3128771573/stm32-test/level_dashboard_2026-10-09/docs/screen-simplified.png

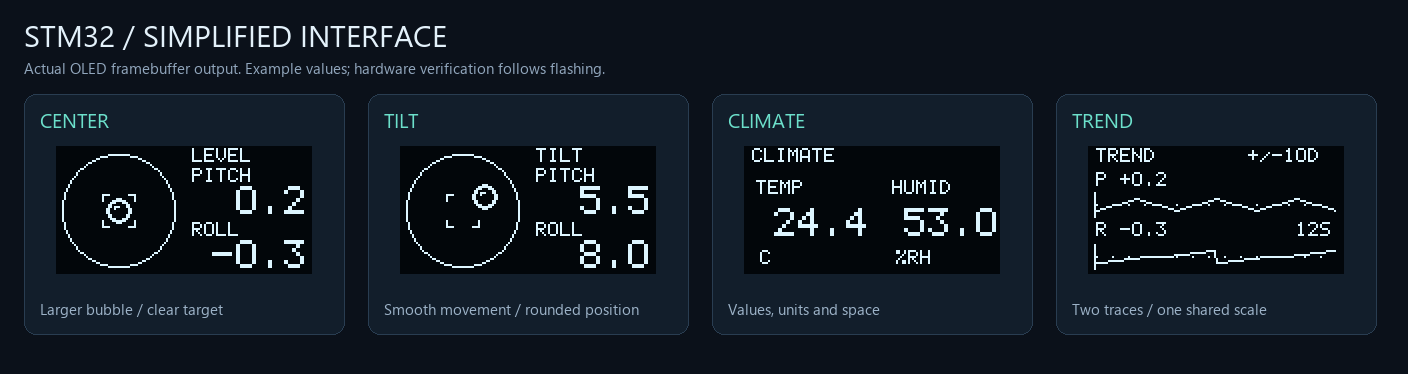
level_dashboard_2026-10-09/docs/screen-simplified.png
