3128771573/stm32-test/level_dashboard_2026-10-09/docs/screen.png

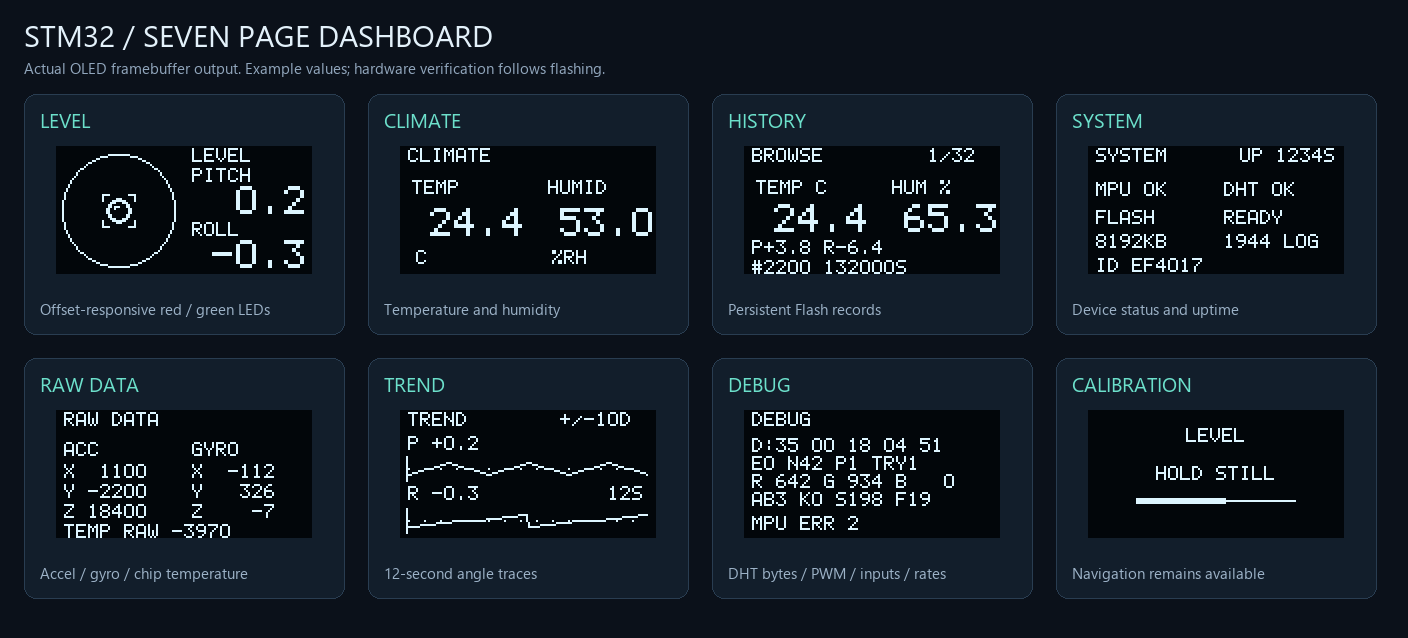
level_dashboard_2026-10-09/docs/screen.png
