3128771573/stm32-test/level_dashboard_2026-10-09/docs/validation.md

# 软件验证与实机验收

> 当前发布：2026-10-10 E（屏显版本 `20261010E`）。本页先列当前版本的构建与验收状态，后半部分保留此前迭代的测试记录供追溯。

## 当前发布：2026-10-10 E

| 检查项 | 结果 |
|---|---|
| Keil ARM Compiler 5.06 update 7 | 0 错误、0 警告 |
| ROM（map Total ROM） | 31,536 B |
| RAM（RW + ZI） | 8,048 B |
| 当前 HEX SHA-256 | `E5E01E7FB6E05E1369147C6647CB159F22D57C45F70B46F334656BDD6B7F6FB8` |
| 本次新增 | 开机序号、复位原因、当前运行时长、Flash 历史会话与 60 秒检查点 |
| 待板上验收 | 开机事件提交/读回、会话浏览、断电后的时长下界、并行运行稳定性 |

PC 逻辑验证通过不等于真实 Flash 掉电行为已验收。每分钟检查点只能给出意外断电前时长下界；没有后备电源时无法保存准确断电时刻。逐步验收方法见[页面与硬件验收](dashboard.md)。

`screen.png` 和 `screen-simplified.png` 是早期七页版本的绘图示例，保留作历史布局参考；其中不包含 STROBE、RUNTIME、SESSIONS，不能代表当前完整页面。当前接线和操作以新版 README 及本目录其他文档为准。

## 历史迭代验证记录

以下资源数、页面截图和验收结论对应各自标题中的旧版本，不能用于描述当前 E 版。原 ST 标准库未修改；USER 源码保持 GBK，build.cmd 保持 CRLF。

## 本次一次性断言检查

测试代码放在系统 TEMP，直接使用真实 main / oled / logger / dht11 / controls / dashboard 代码，替换外设访问。
GCC C99：Wall / Wextra / Werror，仅豁免原第三方字库的 missing-braces 提示。
未重新建立 level_sim，也没有在工程中留下 PC 仿真框架。

- DHT11 校验和正确 / 错误、小数温度、负温度编码验证通过。
- 通过真实 EXTI1_IRQHandler 注入响应和 40 位下降沿，验证收满一帧、TIM2 16 位回绕和超时错误。
- 编码器完整四边沿周期只产生一个事件，往返抖动取消；按键去抖、短按、长按及松手不重复短按通过。
- 后台校准 100 次正常完成；有效样本不足、明显运动、倒置均拒绝。
- Flash 记录正文写入后、提交前中断，再初始化扫描，未提交记录不计入有效数据。
- 下一次保存跳过未提交槽，不覆盖上一条已提交记录。
- 修改已提交记录的数据字节造成 CRC 错误，扫描忽略损坏记录。
- 未知非空数据触发 FOREIGN/LOCKED，拒绝写入并保留原字节。
- 模拟编程未生效，回读检测为 ERROR；模拟擦除长时间忙，截止时间后返回 ERROR。
- 连续写入 2200 条记录，跨过 2048 槽边界；当时有效数 1944，最新序号 2200。
- 重启扫描后仍为 1944 条，最近 32 条按 2200、2199……2169 正确排序。
- 各页及校准页从实际绘图函数导出，检查标题、数字、单位、记录时间和页码；screen.png 为合成样例值预览。

测试中的 Flash 后端执行 NOR 的 1→0 编程、4KB 扇区擦除和忙状态，以验证记录状态机。
它不替代真实 SPI 电气时序、擦写耗时、掉电电压曲线或 DHT11 实测脉冲；这些由板上验收确认。

## 保留的水平仪优化

前一版已检查连续滤波、数字滞回、水平进入/退出保持、时钟回绕和 OLED 差分重发。
当时 ±200 LSB 交替输入，稳定输出峰值 6 LSB；4800 LSB 阶跃第 40 个样本误差 61 LSB。
本版保留该滤波和判定逻辑，新增独立页面与后台校准。

原七阶段水平仪有完整硬件通过记录；本多功能版 DHT 恢复读取已由用户确认，其余新增行为仍需逐项验收。
完整接线和每项可观测验收见 [dashboard.md](dashboard.md)。

## 2026-10-09 按压 / DHT 诊断补充

增加按住 KEY DOWN、系统页 K:UP/K:DOWN、长按 HOME 提示和 DHT 的 E/N/P/TRY 诊断。
DHT 请求期间开漏输出，接收期间切换输入上拉。
本次 AC5 编译 0 错误、0 警告，Code=15952、RO=2032、RW=200、ZI=3392 字节。
临时测试验证输入/输出模式切换、无响应 E3、请求前低电平超时 E5、异常间隔 E4、恢复正常后 N42，以及按住/松手状态和短长按事件。
原温湿度解码、校准、Flash 掉电和循环记录测试继续通过；仍需用户烧录后反馈实际诊断码。

## DHT 一直 E3 N0 的根因与修复

用户实测：TRY 持续增加，PA1 接地后 P0/E5，三针模块直连后仍 E3 N0 P1。
检查实际 stm32f10x_exti.c 发现 EXTI_Init(LineCmd=DISABLE) 只关掩码，不配置触发寄存器。
原驱动在此分支初始化，随后只打开 IMR，导致 FTSR 的 EXTI1 位一直为 0，传感器下降沿无法触发接收。
修正为 LineCmd=ENABLE 先完成下降沿配置，再手动屏蔽 IMR，接收前启用。

旧临时测试把 EXTI_Init 替换为空函数并直接调用 ISR，验证了脉冲解码，但漏掉触发寄存器配置，不能作为此前 EXTI 链路正确的证据。
本次从项目原厂库提取实际 EXTI_Init 函数，仅把地址临时变量/转换改成 uintptr_t 以适配 64 位测试宿主。
对照相同函数的初始化结果：旧版 FTSR=0、IMR=0；修复版 FTSR=2、IMR=0。
回归脉冲必须经过 FTSR 与 IMR 门控才能进入真实 DHT ISR，完整帧、超时、错误脉冲与恢复测试通过。
AC5 编译 0 错误、0 警告，Code=15972、RO=2032、RW=200、ZI=3392 字节。
修复确切的初始化缺陷；实际模块通信恢复仍需用户烧录新 hex 验收。

## LED PWM 平滑优化

用户随后确认 DHT11 已恢复正常。
LED 从 SysTick 100Hz、9 档软件 PWM 改为 TIM1 三通道 2kHz、3600 级硬件 PWM。
临时测试运行真实 controls.c，检查 PSC/ARR、PWM1、预装载、通道输出和高级定时器 MOE 配置。
视觉补偿在全部 65281 个 Q8 输入上单调且有界，0 输入全灭、满输入占空比 3600。
蓝色 3 秒呼吸实算占空比 10–1789，包含 260 种亮度值，最大单步变化 16/3600。
测试蓝灯峰值时切绿灯的渐变、保存最低可见时长、红色脉冲及快速改变状态，三通道均未越界。
原 DHT 实际 EXTI 库配置 / 波形、按键、校准和 Flash 回归测试通过。
AC5 编译 0 错误、0 警告，Code=16616、RO=2032、RW=220、ZI=3388 字节。
电气波形、各色 LED 实际亮度和观感由用户烧录后验收。

## 首页偏移灯与七页调试界面

新增 LIGHT_OFFSET：首页使用径向角度映射红/绿亮度，保留 TIM1 PWM、视觉补偿、页面换色渐变与保存提示。
测试从 0 到 15° 的 151 个偏移，红灯稳态占空比单调，中心红灯为 0、边缘封顶；3/4/5 三角径向距离、正负方向对称、极大输入限幅、回零平滑均通过。
新增 RAW DATA、TREND、DEBUG，实际绘图函数已导出全部七页和校准页示例到 screen.png（例数不是硬件读数）。
真实 MPU6050_ReadAll 函数测试验证单次 14 字节事务、-32768/32767 等有符号边界、陀螺/温度字节顺序，以及读取失败不覆盖旧输出。
趋势测试覆盖 100ms 节拍、漏采留空、120 点环绕、毫秒时钟回绕与自动量程；DHT 原始帧缓存与有效标记测试通过。
原按键、DHT 实际 EXTI 库配置/波形、校准、Flash CRC/断电/2200 次循环记录回归通过。
本次 AC5 编译 0 错误、0 警告：Code=18696、RO=2076、RW=240、ZI=3992 字节，ROM 20772 字节、静态 RAM（含工程栈/堆预留）4232 字节。
从 MPU 连读 6 字节改为 14 字节后，采样目标仍为 5ms；实机实际速率及趋势画面刷新效果可在 DEBUG 查看并验收。

## 界面收简与气泡效果

日常页移除常驻页码圆点、上下分隔线、操作提示；温湿度诊断码移到 DEBUG，历史浏览标题显示 BROWSE。
首页圆盘半径从 20 增至 28px，气泡从 3 增至 6px；中心定位角、双层轮廓与高光取代穿过气泡的十字。
气泡 Q8 位置采用约 45ms 时间相关平滑、对称像素取整和 160/256px 更新阈值，首页目标刷新间隔改为 33ms。
测试覆盖 +/-300° 输入的径向限幅与正负对称、方向翻转后收敛、细微抖动不来回跳像素、计时回绕；原 DHT/按键/趋势/校准/Flash 回归通过。
实际绘图代码输出的居中/倾斜/温湿度/趋势预览见 screen-simplified.png，全部页面预览见 screen.png；均为例数。
AC5 编译 0 错误、0 警告：Code=18852、RO=2080、RW=256、ZI=3992 字节；ROM=20932、静态 RAM（含栈/堆预留）=4248 字节。
需要板上验收缓慢倾斜、快速转向、居中静止及连续翻页时的实际观感和 F 速率。

## 纯旋转浏览、静置渐暗与恢复保护

实物编码器无 SW，新版在 HISTORY 有记录时停留 800ms 自动进入 BROWSE；查看最新记录时继续向更新方向退出到 CLIMATE，
查看最旧记录时继续向更旧方向退出到 SYSTEM。快速连续旋转仍能翻页，独立按钮手动退出浏览后不自动重入。
测试覆盖进入计时边界、两端退出、空记录、单条记录、一次累计多格、正负极限事件、手动禁止自动进入和毫秒回绕。

静置 45 秒渐暗，OLED 对比度从 0xCF 逐步减到 0x28；旋转、按钮、相对静置基线累计 0.3° 变化或当前故障提示唤醒。
测试覆盖 44999/45000ms 边界、输入唤醒、缓慢累计角度变化、故障禁止渐暗和毫秒回绕。
大号数值固定为五字符右对齐，验证 0.0、-0.1、10.0、-10.0、100.0 和 OVER；实际代码导出的页面预览已更新。

修复仅看 X/Y 时倒置仍可能显示水平的问题：原始负 Z 立即拒绝，原始/滤波 Z 低于校准 Z 四分之一也拒绝。
无效姿态撤销水平锁存、关闭蜂鸣；趋势留空、保存不标角度有效，RAW DATA 保持原值可读。
测试覆盖正常、翻面、零 Z、阈值不足、转回正面但滤波未恢复、恢复正常，以及关闭已锁存水平/正在鸣叫的状态。

OLED 写失败后暂停刷新，以 500ms 节流逐条重发 16 条完整初始化命令，每次后台 Service 至多一笔 I2C 事务。
测试覆盖正常初始化和 32 块刷新、显存不变零事务、断线期间暂停、重配置中途失败从头重试、成功后全量补刷且保留当前显存、
对比度写失败、超过 2^31ms 后首次唤醒、截止时间跨回绕，以及初始化失败不会陷入刷新死循环。

GCC -Wall -Wextra -Werror 检查通过，仅豁免原第三方字库的 missing-braces；临时测试代码仍只保存在 TEMP。
DHT 真实 SPL EXTI 门控与波形、编码器事件、校准、MPU 14 字节读取、气泡、趋势、PWM、Flash CRC/断电/2200 条循环记录回归通过。
AC5 编译 0 错误、0 警告，资源数见本文开头；上一轮 HEX 保留为 MDK-ARM/Obj/level_previous.hex，便于板上对照。
完整重建后检查 HEX 各行校验和、结束记录、64KB Flash 地址范围、栈指针对齐和 Thumb 复位向量通过，实际载荷 22288 字节。
同步检查 USER 源码 GBK、README/readme 内容一致、build.cmd CRLF；工作区未创建 .git，也未恢复 level_sim。
这些检查验证软件路径，新增渐暗观感、纯旋转操作及 OLED 掉线恢复仍需烧录后确认，验收步骤见 dashboard.md。

## 红蓝爆闪独立页面

新增第八页 STROBE，开机默认 DOUBLE，仅在该页独占红/蓝灯，绿色关闭；OFF 档三灯全灭。
800ms 停留自动进入 MODE，无按压编码器即可切档；OFF 左端退出 DEBUG、CHASE 右端退出 LEVEL。
模式只存 RAM，退出恢复状态灯；自动日志和传感器任务照常运行。

真实 controls.c 的 1ms Tick 验证三个周期：ALT 400ms、红蓝各亮160ms各1次；DOUBLE 800ms、各亮140ms各2次；
TRIPLE 960ms、各亮135ms各3次；CHASE 1000ms、各亮240ms各4次。
所有样本 CCR1/CCR3 仅取0或3600、不同时点亮，CCR2始终0，无正常呼吸或换色渐变侵入。
OFF及非法模式输入、切档相位重启、10万次Tick保持周期边界、进入时打断保存灯保持、爆闪期间旋转和长按、退出恢复绿色/偏移灯通过。
页面测试覆盖799/800ms边界、全部档位和两端退出、快速通过页面、累计多格、手动退出编辑不重入和毫秒回绕。

原DHT真实SPL门控/波形、编码器、姿态、校准、历史浏览、渐暗、Flash断电/CRC/2200条循环、趋势、气泡和旧PWM检查通过。
当时绘图函数输出 MODE/DOUBLE 与 OFF 页面，R/B 窗只是画面采样，不代表每个实物脉冲；当前 `docs/strobe.png` 已在下述稳定性复核中重绘，R/B 窗已移除。
Keil AC5：0错误、0警告，资源数见本文开头；修改的USER源码已恢复GBK，build.cmd保持CRLF。
链接器压缩RW初始化数据：map的实际Total ROM Size及HEX载荷均为23392字节；Code+RO+未压缩RW之和为23644字节。
改动前固件保留为MDK-ARM/Obj/level_before_strobe.hex；本轮仍需烧录验收真实亮度及手感。

## 开机 SYSTEM POST 逐项自检

去掉按固定时长增长的动画进度，改为按结果推进。第一页依次检查 RCC 时钟配置、SysTick 寄存器并等待一次真实毫秒节拍、TIM2 配置并等待计数达到 100µs、OLED I2C ACK、MPU6050 初始化及五个配置寄存器回读。第二页等 DHT11 完成首帧及数据校验，再读 W25QXX JEDEC / 容量，并由 Logger 实际扫描末尾 64KB 日志区域；最后核对编码器输入以及 RGB PWM / 蜂鸣器 GPIO 的配置寄存器。

每行先显示 `TEST`，实际检查结束并将对应状态刷新到 OLED 后才检查下一项。`CHECKS n/10` 是已得出结果的数量，包含 `ERR` / `SKIP`，不是成功率；进度条只表示这些结果项，Flash 扫描阶段使用 `Logger_ScanProgress()` 的真实已读记录数。DHT `WAIT` 期间真实发起一次采集；`CRC OK` 只在首帧有效时出现。Flash 的 `DONE` 表示槽位遍历完成且没有总线错误或未知格式锁定；CRC 无效、未提交的条目依照原日志规则跳过，不作为有效记录计入。DHT 超时、Flash 未识别、其他格式日志触发 `LOCK` 都如实显示，均不阻止进入主仪表。日志检查只读，不写入或擦除 Flash。`CFG` 仅核对引脚和定时器配置，不能测量 LED 实际亮度、蜂鸣器音量或旋转编码器电气响应。

复核 POST 时序时修复两处问题：DHT11 后台任务只在传感器初始化完成后启动；Flash 日志扫描只在 `LOG AREA` 的 `SCAN` 提示实际刷新完成后开始。扫描完成后的状态判断也覆盖 `DONE`、`LOCK`、`SKIP`，避免正常扫描提前结束被误报为 `ERR`。SysTick 或 TIM2 自检失败时，DHT11 初始化被跳过，主循环也不会启动未初始化的 DHT11 任务。

Keil ARM Compiler 5.06 update 7 工程构建：0 错误、0 警告；Code=23816、RO-data=2496、RW-data=352、ZI-data=3992 字节。链接图的 Total ROM Size 为 26404 字节、Total RW Size 为 4344 字节。Intel HEX 共 26404 个数据字节，范围 0x08000000–0x08006723；所有记录校验和正确，包含 EOF 记录，栈指针 0x200010F8 按 8 字节对齐，复位向量 0x08000105 指向 Thumb 代码，未越过 64KB Flash。SHA-256：`3A42E5D99005035FB4D58FE6974DB2CF6677E7A172BC2C8395E51E60AC014A83`。新 POST 未增加全局显存缓冲区，但实物 OLED、DHT11、Flash 和灯效结果仍待烧录验收；本次没有把编译或固件结构检查冒充为硬件通过。改动前 HEX 保留在 `../MDK-ARM/Obj/level_before_post.hex`。

## 2026-10-10 稳定性复核与界面收简

I2C 起始会检查释放后的 SCL/SDA 电平，每个传输时钟核对 SCL 实际升高，并以 1ms 与有限循环双重限制等待。测试直接编译真实 `i2c.c`，在临时外设桩中覆盖正常 ACK、无设备、SDA 持续拉低、SCL 持续拉低和解除故障后重新探测；故障线不再误报在线，读写返回错误。开机 OLED 缺席时保留板载 LED 闪码，每组闪码后重新探测，屏幕接回后再进入 POST。

Flash 仅在运行中 `LOG_ERROR` 后启动 5s 延时重试；重试初始化后先扫描现有末尾 64KB，持续失败采用最高 60s 的退避。扫描遇未知格式仍保持 LOCKED，没有自动擦写。临时测试直接编译真实 `logger.c`，覆盖写正文后失联、重扫忽略未提交记录、随后写入下一空槽、写入期间历史读取不干扰保存、历史读取通信失败转入错误状态并重扫、未知格式只读锁定；均通过。正在擦除扇区时断电后的不确定字节仍可能触发 LOCKED，未宣称已自动修复该情况。

DEBUG 底行加入自进入主界面以来的最大采样尝试间隔 G、最大主循环间隔 L（毫秒，封顶显示 999），保留 MPU 失败计数 E。SYSTEM 显示固件版本 `20261010B` 和 RCC 上次复位标志；读取后清除标志，避免多次启动混淆。时钟、SysTick、TIM2 中任一 POST 检查失败时，在 OLED 上显示 TIMEBASE FAULT 并转入板载 LED 故障闪烁，跳过依赖该计时基准的传感器任务。STROBE 去掉按画面采样的 R/B 假动态窗口，保留模式名与档位点，操作提示仅在进入后的约两秒出现；新 `strobe.png` 由当前实际 OLED 绘图代码导出。

Keil AC5 构建 0 错误、0 警告：Code=24676、RO=2496、RW=356、ZI=3996；map Total ROM=27260、Total RW=4352 字节。HEX 实际载荷 27260 字节，地址 0x08000000–0x08006A7B，所有 Intel HEX 行校验和正确且包含 EOF；初始栈指针 0x20001100 对齐，复位向量 0x08000105 为 Thumb 地址，未越过 64KB。SHA-256：`D1D6C3F9302B51C18EFE4D4830982632257C5568240946B1BBDD867C62333BBD`。修改前固件保留在 `../MDK-ARM/Obj/level_before_review.hex`；源码为 GBK，未恢复 PC 仿真目录。板上仍需验证真实 I2C 接触故障、Flash 掉线重扫、G/L 实际数值与灯效观感。

## 2026-10-10 快速开机版

POST 移除逐项结果后的固定停顿，合计去掉约 2.6 秒纯展示等待；各项 `TEST` 和真实结果仍各完成一次 OLED 刷新。时钟、SysTick、TIM2 实测通过后立刻初始化 DHT，使其约两秒的首次采集等待与 OLED/MPU 检查重叠；DHT 行仍等首帧结束并按校验结果显示 `DONE` / `ERR` / `TIME`。Flash 仍逐条读取末尾 64KB，进度显示由每 1% 更新调整为约每 5% 更新，结果仍等扫描完成。OLED 上电前 300ms 等待、MPU 复位等待及传感器实际采集时间保持原值；预期提速不能冒充板上实测。

Keil AC5 构建 0 错误、0 警告：Code=24544、RO=2496、RW=356、ZI=3996；map Total ROM=27132、Total RW=4352 字节。HEX 实际载荷 27132 字节，地址 0x08000000–0x080069FB，逐行校验和正确且包含 EOF；初始栈指针 0x20001100 对齐，复位向量 0x08000105 为 Thumb 地址，未越过 64KB。SHA-256：`B71475F1853E915FBCAF82AE97B3C316DE949CEEC8158E12D62FF9800720DDE5`。系统页版本 `20261010C`，上一版保留在 `../MDK-ARM/Obj/level_before_fastboot.hex`。板上仍需对比冷启动到首页的实际时间，检查 DHT 首帧、Flash 日志和逐项结果。

## 2026-10-10 RTC、运行诊断与开机事件版

RTC 使用当前工程的 8MHz HSE，经 /128 与 62499 预分频形成 1Hz 秒计数；日期、星期和闰年由纯整数换算。后备域双标记及秒数范围共同判断时间是否有效：未接 VBAT 的完整断电后显示 `SET`，不会重复使用旧日期。临时桩直接编译 `clock.c`，覆盖 2020-01-01、2024-02-29、2026-10-10 星期换算、非法日期拒绝、RTC 配置、带电复位保时与模拟冷断电失效；均通过。实物晶振精度和 VBAT 行为仍待板验。

W25QXX 末尾原 64KB 传感器日志未改；其前方 8KB 双扇区单独存放 BOOT、TIME SET、15 分钟存活标记。32 字节事件先写正文、回读，再写提交字节并校验；扫描按序号恢复最近记录，非本项目格式锁定，不自动擦除。页面可浏览保留的每条事件。临时 NOR 桩直接编译 `eventlog.c`，覆盖连续重启计数、上次事件恢复、未提交正文断电、超过 256 次事件的扇区轮换、倒序浏览、异格式数据锁定和与原末尾 64KB 隔离；均通过。断电恰好打断擦除时，事件区可能保守锁定，未把它算作自动恢复。

POST 改为三屏 12 项：保留原 10 项，再核对 RTC 配置与时间有效性，以及实际扫描事件区、提交并回读本次 BOOT。RTC 可工作但未校时显示 `SET`，EVENT 只有本次记录完成才显示 `DONE`。TIME 页可用 A/C/B 编码器四次快速交替旋转进入校时，五个字段按 1.5 秒无操作依次确认；EVENTS 页可浏览运行事件。当前开机时长与两种日志的 uptime 字段已扩展处理 32 位毫秒计数回绕。**正常或意外断电的精确时刻都无法靠无后备电源的板子直接写入 Flash**；TIME 底部展示的只是上一轮最后确认仍在运行的下界，不声称区分主动拔电与故障掉电。

Keil AC5 构建 0 错误、0 警告：Code=31780、RO=2600、RW=496、ZI=5600；map Total ROM=34516、Total RW=6096 字节。HEX 实际载荷 34516 字节，地址 0x08000000–0x080086D3，逐行校验和正确且包含 EOF；初始栈指针 0x200017D0 按 8 字节对齐，复位向量 0x08000105 为 Thumb 地址，未越过 64KB。SHA-256：`4AB6DC51A99C784DCCE5CF4A66D7EEFD06EA572A04D6FEC7197A90588CFEFDAE`。SYSTEM 版本 `20261010D`；改动前固件保留在 `../MDK-ARM/Obj/level_before_clock.hex`。实物上还需确认 RTC 一秒节拍、校时手势、软复位/完整断电、Flash 写入与灯效/采样并行表现。

## 2026-10-10 开机时长会话版（20261010E）

按用户选择移除硬件 RTC、日期和校时功能，改用现有 SysTick 记录运行时长。RUNTIME 页显示当前会话天数、日内时分秒、开机序号和复位原因；SESSIONS 页只列每次 BOOT，会话历史按 boot_count 聚合 60 秒一次的存活检查点，不把心跳显示成独立事件。当前会话实时计时；历史时长以最后检查点作为下界，显示 `>=`，无检查点时显示 `NO CHECKPOINT`。突然掉电无法写入最终时长，精确关机时刻不可得。

事件格式保留原 32 字节 CRC 与提交标记；读取器仍识别上一版的旧校时事件，但页面不再显示日期或校时记录。扇区循环覆盖时同步移除已擦除扇区里的会话索引。事件区每分钟写入一次存活点，窗口容量有限；末尾 64KB 温湿度 / 角度日志区域和接线均未改变。POST 调整为 11 项，不再对无用 RTC 做自检；EVENT `DONE` 仍代表本次 BOOT 记录完成写入并读回确认。

Keil ARM Compiler 5.06 update 7 构建：0 错误、0 警告；Code=28912、RO-data=2524、RW-data=420、ZI-data=7628 字节；map Total ROM=31536、Total RW=8048 字节。HEX SHA-256：`E5E01E7FB6E05E1369147C6647CB159F22D57C45F70B46F334656BDD6B7F6FB8`。改动前的 RTC 版本 D 未单独留存；可用 `../MDK-ARM/Obj/level_before_clock.hex` 回退到 RTC 之前的版本 C。本次确认的是编译结果；SESSION 聚合和实物 Flash 保存 / 断电恢复仍待上板验收。
