3128771573/stm32-test/(commit log)

2026-10-08 STM32F103C8T6 姿态水平仪（电子气泡）：MPU6050 + SSD1306 + 蜂鸣器
2026-10-08 gitignore: 排除 SSH 推送密钥目录
2026-10-10 Polish project documentation and release landing pages
